Bloodmosher/Sysop-64/Boards/DE10-Nano/Top_Plates/Sysop-64_3_Button_Logo/V1.6/DE10-V1.6-HatC-BOM.txt

Comment	Designator	Footprint	JLCPCB Part #?optional?
RT0805BRB0710KL	"R1,R2"	R0805	C864029
CRGCQ0805J470R (480 Ohm)	"R3,R4"	R0805	C4236587
TSM-120-03-T-DV-A	J1	 2.54mm Spacing 20p Double row pin header	C21501942
TL1100DF160Q	"SW1,SW2,SW3"	"Plugin, 12x12mm"	C273460
150080BS75000 (Blue 470nm LED)	"D1,D2"	LED_0805	C9900019499
