Bloodmosher/Sysop-64/linux-code/libsysop64/include/sysop_defines.h

/*
 * Sysop-64
 * https://github.com/Bloodmosher/Sysop-64
 *
 * SPDX-License-Identifier: MIT
 * Copyright (c) 2026 Sysop-64 Project
 */

#ifndef SYSOP_DEFINES_H
#define SYSOP_DEFINES_H

#include <stdint.h>

#define SYSOP64_BRIDGE 0xC0000000
#define SYSOP64_BRIDGE_SPAN 0x40bff
#define SYSOP64_SAMPLER_BUFFER_ADDRESS 0x21000000
#define SYSOP64_SAMPLER_BUFFER_SIZE (12500000*8) // 12.5M samples, 8 bytes each
#define SYSOP64_SAMPLER_MAX_SAMPLES 12500000
#define SYSOP64_TICK_SAMPLER_BUFFER_ADDRESS 0x21000000
#define SYSOP64_TICK_SAMPLER_BUFFER_SIZE 0x06000000
#define SYSOP64_TICK_SAMPLER_WORD_BYTES 32
#define SYSOP64_HDMI_CMD_DATA 0x40810
#define SYSOP64_CMD3_PARAM    0x40800
#define SYSOP64_FPGA_STATUS   0x40808
#define SYSOP64_PHI2_COUNTER 0x40818
#define SYSOP64_C64_SIGNALS 0x40820
#define SYSOP64_MAP_DEBUG_DATA1 0x40828
#define SYSOP64_CMD3_RESULT 0x40830
#define SYSOP64_HDMI_INFO_RESULT 0x40838
#define SYSOP64_SID_VOICES_DATA 0x40840
#define SYSOP64_GPIO_DATA 0x40848
#define SYSOP64_DMA_READ_KEY_DATA 0x40850
#define SYSOP64_DMA_TAG_DATA 0x40858
#define SYSOP64_DMA_JOYSTICK_DATA 0x40860
#define SYSOP64_AUDIO_STATUS 0x40868
#define SYSOP64_AUDIO_COMMAND 0x40870

#define SYSOP64_DMA_WRITE_ADDRESS 0x40400
#define SYSOP64_DMA_WRITE_DATA 0x40000
#define SYSOP64_DMA_READ_ADDRESS 0x40402
#define SYSOP64_DMA_READ_DATA 0x40001
#define SYSOP64_CMD_ADDRESS 0x40404
#define SYSOP64_CMD2_ADDRESS 0x40C00
#define SYSOP64_SET_PALETTE_ADDRESS 0x40C04
#define SYSOP64_CMD3_ADDRESS 0x40C08

#define SYSOP64_CMD2_ID_READ 0
#define SYSOP64_CMD2_ID_WRITE 1
#define SYSOP64_CMD2_ID_WAIT_VIC 2

#define SYSOP64_INTERNAL_READ_ADDRESS 0x40406
#define SYSOP64_INTERNAL_READ_DATA 0x40002

#define SYSOP64_CMD_ID_RESET 0
#define SYSOP64_CMD_ID_DMA_FREEZE 1
#define SYSOP64_CMD_ID_DMA_UNFREEZE 2
#define SYSOP64_CMD_ID_ENABLE_CARTRIDGE_8K 3
#define SYSOP64_CMD_ID_DISABLE_CARTRIDGE 4
#define SYSOP64_CMD_ID_NMI_FREEZE 5
#define SYSOP64_CMD_ID_NMI_UNFREEZE 6
#define SYSOP64_CMD_ID_ENABLE_IO 7
#define SYSOP64_CMD_ID_DISABLE_IO 8
#define SYSOP64_CMD_ID_ENABLE_NMI_TRAP 9
#define SYSOP64_CMD_ID_DISABLE_NMI_TRAP 10
#define SYSOP64_CMD_TEST_SDRAM_READ 11

#define SYSOP64_CMD_ID_TRIGGER_SAMPLER 13
#define SYSOP64_CMD_ID_SHOW_FRAMEBUFFER 14
#define SYSOP64_CMD_ID_HIDE_FRAMEBUFFER 15
#define SYSOP64_CMD_ID_FLIP_FRAMEBUFFER 16
#define SYSOP64_CMD_ID_ENABLE_CARTRIDGE_16K 17

#define SYSOP64_CMD_ID_ENABLE_CARTRIDGE_ULTIMAX 25
#define SYSOP64_CMD_ID_ENABLE_EASYFLASH_DMA_TRIGGER 26
#define SYSOP64_CMD_ID_DISABLE_EASYFLASH_DMA_TRIGGER 27

#define SYSOP64_CMD_ID_ENABLE_REU_DMA_TRIGGER 34
#define SYSOP64_CMD_ID_DISABLE_REU_DMA_TRIGGER 35
#define SYSOP64_CMD_ID_TRIGGER_TICK_SAMPLER 41
#define SYSOP64_CMD_ID_STOP_TICK_SAMPLER 42
#define SYSOP64_CMD_ID_TRIGGER_BUSMON_DEBUG_SAMPLER 43
#define SYSOP64_CMD_ID_STOP_BUSMON_DEBUG_SAMPLER 44
#define SYSOP64_CMD_ID_ENABLE_BUSMON_CHL_ALERT 45
#define SYSOP64_CMD_ID_DISABLE_BUSMON_CHL_ALERT 46
#define SYSOP64_CMD_ID_ENABLE_BUSMON_CHL_OVERRIDE 47
#define SYSOP64_CMD_ID_DISABLE_BUSMON_CHL_OVERRIDE 48
#define SYSOP64_CMD_ID_TRIGGER_VIC_DEBUG_SAMPLER 49
#define SYSOP64_CMD_ID_STOP_VIC_DEBUG_SAMPLER 50
#define SYSOP64_CMD_ID_SELECT_SID2_6581 56
#define SYSOP64_CMD_ID_SELECT_SID2_8580 57
#define SYSOP64_CMD_ID_ENABLE_SID2 58
#define SYSOP64_CMD_ID_DISABLE_SID2 59
// archived isevic_debugger: #define SYSOP64_CMD_ID_TRIGGER_ISEVIC_DEBUG_SAMPLER 51
// archived isevic_debugger: #define SYSOP64_CMD_ID_STOP_ISEVIC_DEBUG_SAMPLER 52
// archived isevic_debugger: #define SYSOP64_CMD_ID_ENABLE_ISEVIC_REPLAY 53
// archived isevic_debugger: #define SYSOP64_CMD_ID_DISABLE_ISEVIC_REPLAY 54

#define SYSOP64_CMD3_ID_GET_COLOR 1
#define SYSOP64_CMD3_ID_IO_POKE 2
#define SYSOP64_CMD3_IRQ_SET 3
#define SYSOP64_CMD3_IRQ_CLEAR 4
#define SYSOP64_CMD3_SETUP_WRITE_IO_STROBE 5
#define SYSOP64_CMD3_RESET_STROBE 6
#define SYSOP64_CMD3_SETUP_READ_STROBE 7
#define SYSOP64_CMD3_READ_CPU_FREQ 8
#define SYSOP64_CMD3_READ_LINE_TIMING 9
#define SYSOP64_CMD3_SET_PLL_DATA 10
#define SYSOP64_CMD3_PLL_RECONFIG 11
#define SYSOP64_CMD3_READ_VIC_INFO 12
#define SYSOP64_CMD3_GET_DMA_INFO 13
#define SYSOP64_CMD3_GET_VERSION_INFO 14
#define SYSOP64_CMD3_READ_STATUS_1 15
#define SYSOP64_CMD3_VIDEO_RESET 16
#define SYSOP64_CMD3_SCREENSHOT_REQUEST 17
#define SYSOP64_CMD3_SCREENSHOT_STATUS 18
#define SYSOP64_CMD3_SCREENSHOT_READ 19
#define SYSOP64_CMD3_SET_DMA_TIMING_NTSC 20
#define SYSOP64_CMD3_SET_DMA_TIMING_PAL 21
//#define SYSOP64_CMD3_SET_LINE_NUMBER 22
#define SYSOP64_CMD3_SETUP_RASTER_STROBE 23
#define SYSOP64_CMD3_SETUP_WRITE_STROBE 24
#define SYSOP64_CMD3_NAMESOFT_MIDI_READ_READY 25
#define SYSOP64_CMD3_NAMESOFT_MIDI_WRITE_DATA 26
#define SYSOP64_CMD3_SET_NMI_VECTOR 27
#define SYSOP64_CMD3_SET_TICK_SAMPLER_CONFIG 28
#define SYSOP64_CMD3_READ_TICK_SAMPLER_STATUS 29
#define SYSOP64_CMD3_READ_INFERRED_PORT_01 30
#define SYSOP64_CMD3_RESET_C64_BUS_MONITOR 31
#define SYSOP64_CMD3_READ_PORT01_DEBUG0 32
#define SYSOP64_CMD3_READ_PORT01_DEBUG1 33
#define SYSOP64_CMD3_READ_PORT01_DEBUG2 34
#define SYSOP64_CMD3_READ_PORT01_DEBUG3 35
#define SYSOP64_CMD3_READ_PORT01_DEBUG4 36
#define SYSOP64_CMD3_READ_PORT01_DEBUG5 37
#define SYSOP64_CMD3_READ_PORT01_DEBUG6 38
#define SYSOP64_CMD3_READ_PORT01_DEBUG7 39
#define SYSOP64_CMD3_READ_PORT01_DEBUG8 40
#define SYSOP64_CMD3_READ_PORT01_DEBUG9 41
#define SYSOP64_CMD3_READ_PORT01_DEBUG10 42
#define SYSOP64_CMD3_READ_PORT01_DEBUG11 43
#define SYSOP64_CMD3_READ_PORT01_DEBUG12 44
#define SYSOP64_CMD3_READ_PORT01_DEBUG13 45
#define SYSOP64_CMD3_READ_PORT01_DEBUG14 46
#define SYSOP64_CMD3_READ_PORT01_DEBUG15 47
#define SYSOP64_CMD3_READ_PORT01_DEBUG16 48
#define SYSOP64_CMD3_READ_PORT01_DEBUG17 49
#define SYSOP64_CMD3_WRITE_SID_FILTER_TABLE 50
#define SYSOP64_CMD3_SET_SID_FILTER_CONTROL 51
#define SYSOP64_CMD3_SET_SID_FILTER_SCALE 52
#define SYSOP64_CMD3_WRITE_SID_FILTER_TABLE_SID2 53
#define SYSOP64_CMD3_SET_SID_FILTER_CONTROL_SID2 54
#define SYSOP64_CMD3_SET_SID_FILTER_SCALE_SID2 55
#define SYSOP64_CMD3_SET_SID2_BASE 56

#define VIC_CHIP_6567R56A 0
#define VIC_CHIP_6567R8 1
#define VIC_CHIP_6569 2
#define VIC_CHIP_6572RO_DREAN 3

typedef uint8_t BOOL;
#ifndef TRUE
#define TRUE 1
#endif

#endif /* SYSOP_DEFINES_H */
