Bloodmosher/Sysop-64/linux-code/libsysop64/include/c64keys.h

/*
 * Sysop-64
 * https://github.com/Bloodmosher/Sysop-64
 *
 * SPDX-License-Identifier: MIT
 * Copyright (c) 2026 Sysop-64 Project
 */

#ifndef C64_KEYS_H
#define C64_KEYS_H


#define C64_KEY_STOP 0
#define C64_KEY_RUN 0
#define C64_KEY_Q 1
#define C64_KEY_CMD 2
#define C64_KEY_SPACE 3
#define C64_KEY_2 4
#define C64_KEY_CTRL 5
#define C64_KEY_ESC 6
#define C64_KEY_1 7

#define C64_KEY_SLASH 8
#define C64_KEY_ARROW_UP 9
#define C64_KEY_PI 9
#define C64_KEY_EQUAL 10
#define C64_KEY_RIGHT_SHIFT 11
#define C64_KEY_HOME 12
#define C64_KEY_CLR 12
#define C64_KEY_SEMICOLON 13
#define C64_KEY_STAR 14
#define C64_KEY_LBS 15

#define C64_KEY_COMMA 16
#define C64_KEY_AT 17
#define C64_KEY_COLON 18
#define C64_KEY_PERIOD 19
#define C64_KEY_MINUS 20
#define C64_KEY_L 21
#define C64_KEY_P 22
#define C64_KEY_PLUS 23

#define C64_KEY_N 24
#define C64_KEY_O 25
#define C64_KEY_K 26
#define C64_KEY_M 27
#define C64_KEY_ZERO 28
#define C64_KEY_J 29
#define C64_KEY_I 30
#define C64_KEY_9 31

#define C64_KEY_V 32
#define C64_KEY_U 33
#define C64_KEY_H 34
#define C64_KEY_B 35
#define C64_KEY_8 36
#define C64_KEY_G 37
#define C64_KEY_Y 38
#define C64_KEY_7 39

#define C64_KEY_X 40
#define C64_KEY_T 41
#define C64_KEY_F 42
#define C64_KEY_C 43
#define C64_KEY_6 44
#define C64_KEY_D 45
#define C64_KEY_R 46
#define C64_KEY_5 47

#define C64_KEY_LEFT_SHIFT 48
#define C64_KEY_E 49
#define C64_KEY_S 50
#define C64_KEY_Z 51
#define C64_KEY_4 52
#define C64_KEY_A 53
#define C64_KEY_W 54
#define C64_KEY_3 55

#define C64_KEY_CRSR_DOWN 56
#define C64_KEY_CRSR_UP 56
#define C64_KEY_F5 57
#define C64_KEY_F6 57
#define C64_KEY_F3 58
#define C64_KEY_F4 58
#define C64_KEY_F1 59
#define C64_KEY_F2 59
#define C64_KEY_F7 60
#define C64_KEY_F8 60
#define C64_KEY_CRSR_RIGHT 61
#define C64_KEY_CRSR_LEFT 61
#define C64_KEY_RETURN 62
#define C64_KEY_DELETE 63
#define C64_KEY_INSERT 63

#define C64_KEY_DOWN 1
#define C64_KEY_UP 0


#endif /* C64_KEYS_H */
