Bloodmosher/Sysop-64/linux-code/libsysop64/include/keyboard.h

/*
 * Sysop-64
 * https://github.com/Bloodmosher/Sysop-64
 *
 * SPDX-License-Identifier: MIT
 * Copyright (c) 2026 Sysop-64 Project
 */

#ifndef KEYBOARD_H
#define KEYBOARD_H


#define KEY_STOP 0
#define KEY_RUN 0
#define KEY_Q 1
#define KEY_CMD 2
#define KEY_SPACE 3
#define KEY_2 4
#define KEY_CTRL 5
#define KEY_ESC 6
#define KEY_1 7

#define KEY_SLASH 8
#define KEY_ARROW_UP 9
#define KEY_PI 9
#define KEY_EQUAL 10
#define KEY_RIGHT_SHIFT 11
#define KEY_HOME 12
#define KEY_CLR 12
#define KEY_SEMICOLON 13
#define KEY_STAR 14
#define KEY_LBS 15

#define KEY_COMMA 16
#define KEY_AT 17
#define KEY_COLON 18
#define KEY_PERIOD 19
#define KEY_MINUS 20
#define KEY_L 21
#define KEY_P 22
#define KEY_PLUS 23

#define KEY_N 24
#define KEY_O 25
#define KEY_K 26
#define KEY_M 27
#define KEY_ZERO 28
#define KEY_J 29
#define KEY_I 30
#define KEY_9 31

#define KEY_V 32
#define KEY_U 33
#define KEY_H 34
#define KEY_B 35
#define KEY_8 36
#define KEY_G 37
#define KEY_Y 38
#define KEY_7 39

#define KEY_X 40
#define KEY_T 41
#define KEY_F 42
#define KEY_C 43
#define KEY_6 44
#define KEY_D 45
#define KEY_R 46
#define KEY_5 47

#define KEY_LEFT_SHIFT 48
#define KEY_E 49
#define KEY_S 50
#define KEY_Z 51
#define KEY_4 52
#define KEY_A 53
#define KEY_W 54
#define KEY_3 55

#define KEY_CRSR_DOWN 56
#define KEY_CRSR_UP 56
#define KEY_F5 57
#define KEY_F6 57
#define KEY_F3 58
#define KEY_F4 58
#define KEY_F1 59
#define KEY_F2 59
#define KEY_F7 60
#define KEY_F8 60
#define KEY_CRSR_RIGHT 61
#define KEY_CRSR_LEFT 61
#define KEY_RETURN 62
#define KEY_DELETE 63
#define KEY_INSERT 63

int isShiftKeyDown();

#endif /* KEYBOARD_H */
