Bloodmosher/Sysop-64/linux-code/tools/sidcontrol.c

/*
 * SPDX-License-Identifier: MIT
 * Copyright (c) 2026 Sysop-64 Project
 */

/*
 * Sysop-64 SID filter table uploader.
 *
 * The FPGA custom table is initialized to the Galway curve.  This tool can
 * upload either built-in preset, upload an arbitrary 1024-entry hex/text file,
 * switch the SID filter between the built-in curve and the custom table,
 * and adjust the runtime cutoff scale for the 6581/8580 models.
 */

#include <ctype.h>
#include <errno.h>
#include <math.h>
#include <stdint.h>
#include <stdbool.h>
#include <stdio.h>
#include <stdlib.h>
#include <string.h>
#include <strings.h>
#include <unistd.h>
#include <arpa/inet.h>
#include <netinet/in.h>
#include <sys/socket.h>
#include <sys/types.h>

#include "sysop_library.h"

static const int16_t galway_6581_table[1024] = {
       261,    262,    262,    263,    263,    264,    264,    265,
       265,    266,    266,    267,    267,    267,    268,    269,
       268,    269,    269,    270,    271,    271,    272,    272,
       273,    273,    274,    275,    275,    276,    276,    277,
       276,    277,    278,    279,    279,    280,    281,    281,
       282,    283,    283,    284,    285,    286,    286,    287,
       287,    288,    289,    290,    290,    291,    292,    293,
       293,    294,    295,    296,    297,    298,    299,    300,
       297,    299,    299,    301,    301,    303,    303,    305,
       305,    306,    307,    309,    309,    310,    312,    313,
       313,    314,    315,    316,    317,    319,    320,    322,
       322,    324,    325,    326,    327,    329,    330,    332,
       330,    332,    333,    335,    336,    338,    339,    341,
       342,    343,    345,    347,    348,    350,    351,    353,
       353,    355,    357,    358,    360,    362,    364,    366,
       367,    369,    371,    373,    375,    377,    379,    381,
       369,    371,    373,    375,    376,    379,    381,    384,
       384,    387,    389,    391,    393,    396,    398,    400,
       400,    403,    405,    408,    410,    413,    415,    419,
       420,    423,    425,    428,    430,    433,    435,    439,
       436,    440,    442,    446,    448,    452,    455,    458,
       460,    464,    466,    470,    472,    476,    479,    483,
       483,    487,    490,    494,    497,    502,    505,    510,
       511,    516,    519,    524,    528,    531,    536,    541,
       529,    534,    538,    543,    545,    550,    556,    561,
       561,    567,    572,    576,    580,    586,    590,    596,
       596,    602,    607,    613,    617,    624,    628,    635,
       637,    644,    649,    656,    658,    666,    670,    678,
       673,    680,    685,    693,    698,    706,    711,    720,
       722,    731,    736,    745,    748,    756,    762,    771,
       771,    780,    786,    796,    802,    812,    818,    828,
       831,    841,    848,    858,    865,    872,    883,    894,
       786,    796,    802,    812,    818,    828,    835,    845,
       848,    858,    865,    876,    883,    894,    901,    913,
       909,    920,    932,    943,    947,    959,    967,    980,
       984,    996,   1005,   1018,   1026,   1039,   1048,   1062,
      1048,   1062,   1076,   1090,   1094,   1109,   1118,   1133,
      1138,   1153,   1163,   1178,   1189,   1204,   1215,   1231,
      1231,   1248,   1259,   1275,   1281,   1298,   1316,   1328,
      1333,   1351,   1364,   1382,   1395,   1413,   1426,   1446,
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
};

static const int16_t sysop64_6581_table[1024] = {
       466,    466,    466,    466,    468,    468,    471,    474,
       474,    472,    468,    463,    460,    459,    460,    462,
       465,    469,    472,    477,    480,    480,    477,    475,
       475,    474,    474,    474,    474,    472,    472,    472,
       474,    471,    471,    468,    468,    468,    469,    472,
       475,    475,    478,    480,    482,    485,    488,    490,
       491,    489,    488,    485,    482,    478,    474,    472,
       471,    471,    472,    475,    477,    477,    478,    480,
       480,    478,    477,    474,    474,    474,    477,    479,
       482,    485,    487,    489,    490,    489,    489,    487,
       486,    485,    485,    484,    484,    484,    484,    486,
       486,    485,    483,    482,    482,    481,    481,    483,
       485,    488,    493,    497,    500,    498,    496,    493,
       491,    491,    492,    494,    496,    496,    497,    499,
       499,    497,    494,    490,    491,    494,    501,    507,
       510,    509,    504,    500,    497,    498,    498,    502,
       504,    504,    503,    501,    502,    503,    506,    509,
       512,    512,    512,    512,    513,    513,    514,    516,
       517,    516,    514,    513,    513,    514,    517,    520,
       523,    524,    523,    524,    526,    529,    536,    541,
       543,    539,    531,    523,    520,    522,    528,    534,
       539,    541,    543,    543,    545,    545,    544,    543,
       545,    545,    549,    552,    552,    549,    546,    543,
       543,    548,    557,    566,    573,    575,    573,    570,
       570,    570,    572,    574,    577,    578,    581,    583,
       587,    590,    593,    597,    598,    596,    594,    591,
       591,    594,    598,    604,    608,    608,    606,    605,
       605,    605,    606,    608,    609,    610,    611,    612,
       615,    619,    623,    629,    635,    637,    640,    643,
       646,    648,    651,    653,    655,    654,    653,    653,
       655,    659,    665,    671,    677,    680,    682,    683,
       689,    696,    707,    717,    724,    724,    718,    713,
       713,    717,    725,    735,    742,    743,    743,    743,
       745,    749,    755,    760,    767,    772,    777,    782,
       788,    792,    799,    806,    811,    812,    815,    816,
       822,    827,    838,    848,    856,    861,    866,    869,
       875,    880,    888,    897,    903,    909,    911,    914,
       920,    928,    940,    952,    960,    965,    968,    972,
       978,    985,    996,   1006,   1017,   1026,   1034,   1043,
      1053,   1062,   1072,   1082,   1092,   1102,   1110,   1119,
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
};

static void usage(const char *argv0)
{
    fprintf(stderr,
        "Usage:\n"
        "  %s builtin\n"
        "  %s custom\n"
        "  %s sid-6581 | 6581\n"
        "  %s sid-8580 | 8580\n"
        "  %s sid-volume <0-255>\n"
        "  %s upload-galway [--activate]\n"
        "  %s upload-follin [--activate]\n"
        "  %s upload-average [--activate]\n"
        "  %s upload-strong [--activate]\n"
        "  %s upload-extreme [--activate]\n"
        "  %s upload-sysop64 [--activate]\n"
        "  %s upload <table.hex> [--activate]\n"
        "  %s scale-6581 <scale>\n"
        "  %s scale-8580 <scale>\n"
        "  %s sid2-enable\n"
        "  %s sid2-disable\n"
        "  %s sid2-base DE00|DE20|...|DFE0\n"
        "  %s server [port] [html-path]\n"
        "\n"
        "Tables are 1024 signed 16-bit entries. File input accepts hex values,\n"
        "one or more per line; // comments are ignored.\n",
        argv0, argv0, argv0, argv0, argv0, argv0, argv0, argv0, argv0, argv0,
        argv0, argv0, argv0, argv0, argv0, argv0, argv0, argv0);
}


static int parse_scale_q8_8(const char *text, uint16_t *out)
{
    char *end = NULL;
    errno = 0;
    double value = strtod(text, &end);
    if (end == text || *end != '\0' || errno != 0 || value < 0.0) {
        return -1;
    }

    double scaled = value * 256.0;
    if (scaled > 65535.0) {
        return -1;
    }

    *out = (uint16_t)(scaled + 0.5);
    return 0;
}

static int parse_u8(const char *text, uint8_t *out)
{
    char *end = NULL;
    errno = 0;
    unsigned long value = strtoul(text, &end, 0);
    if (end == text || *end != '\0' || errno != 0 || value > 255) {
        return -1;
    }
    *out = (uint8_t)value;
    return 0;
}

static uint8_t selected_sid = 1;

static int parse_sid_number(const char *text, uint8_t *sid)
{
    if (strcmp(text, "1") == 0 || strcmp(text, "sid1") == 0 || strcmp(text, "SID1") == 0) {
        *sid = 1;
        return 0;
    }
    if (strcmp(text, "2") == 0 || strcmp(text, "sid2") == 0 || strcmp(text, "SID2") == 0) {
        *sid = 2;
        return 0;
    }
    return -1;
}

static int set_sid_model_for(uint8_t sid, const char *model)
{
    if (strcmp(model, "6581") == 0 || strcmp(model, "sid-6581") == 0 || strcmp(model, "--sid-6581") == 0) {
        sysop_sid_set_model(sid, false);
        return 0;
    }
    if (strcmp(model, "8580") == 0 || strcmp(model, "sid-8580") == 0 || strcmp(model, "--sid-8580") == 0) {
        sysop_sid_set_model(sid, true);
        return 0;
    }
    return -1;
}

static int set_sid_model(const char *model)
{
    return set_sid_model_for(selected_sid, model);
}

static int parse_sid_base(const char *text, uint16_t *base)
{
    char *end = NULL;
    int radix = 16;
    errno = 0;
    if (text[0] == '0' && (text[1] == 'x' || text[1] == 'X')) {
        radix = 0;
    }
    unsigned long value = strtoul(text, &end, radix);
    if (end == text || *end != '\0' || errno != 0 || value < 0xde00 || value > 0xdfff || (value & 0x1f) != 0) {
        return -1;
    }
    *base = (uint16_t)value;
    return 0;
}
static int parse_value(const char *token, int16_t *out)
{
    char *end = NULL;
    int base = 16;

    if (token[0] == '-' || token[0] == '+') {
        base = 0;
    } else if (token[0] == '0' && (token[1] == 'x' || token[1] == 'X')) {
        base = 0;
    }

    errno = 0;
    long value = strtol(token, &end, base);
    if (end == token || *end != '\0' || errno != 0) {
        return -1;
    }

    if (value < -32768 || value > 0xffff) {
        return -1;
    }

    *out = (int16_t)(uint16_t)value;
    return 0;
}

static int load_table_file(const char *path, int16_t *table, size_t count)
{
    FILE *fp = fopen(path, "r");
    if (!fp) {
        perror(path);
        return -1;
    }

    char line[512];
    size_t index = 0;
    while (fgets(line, sizeof(line), fp)) {
        char *comment = strstr(line, "//");
        if (comment) {
            *comment = '\0';
        }

        char *token = strtok(line, " \t\r\n,");
        while (token) {
            if (index >= count) {
                fprintf(stderr, "%s: too many entries\n", path);
                fclose(fp);
                return -1;
            }
            if (parse_value(token, &table[index]) != 0) {
                fprintf(stderr, "%s: invalid value '%s'\n", path, token);
                fclose(fp);
                return -1;
            }
            index++;
            token = strtok(NULL, " \t\r\n,");
        }
    }

    fclose(fp);

    if (index != count) {
        fprintf(stderr, "%s: expected %zu entries, got %zu\n", path, count, index);
        return -1;
    }

    return 0;
}


static uint16_t sid_default_fc_dac(uint16_t fc)
{
    static const uint16_t dac_6581_cutoff_bits[11] = {
        0x0020, 0x002f, 0x0052, 0x009c, 0x012b, 0x0243,
        0x0463, 0x0880, 0x107b, 0x1ff4, 0x3df3
    };
    uint32_t sum = 1u << 3;

    for (unsigned bit = 0; bit < 11; bit++) {
        if (fc & (1u << bit)) {
            sum += dac_6581_cutoff_bits[bit];
        }
    }

    return (uint16_t)(sum >> 4);
}

static int16_t clamp_s16_long(long value)
{
    if (value < -32768) {
        return -32768;
    }
    if (value > 32767) {
        return 32767;
    }
    return (int16_t)value;
}

static void fill_6581_curve_table(int16_t *table, double fc_base, double curve_shift)
{
    const double fc_offset = 1024.0 + 512.0 + curve_shift;

    for (uint16_t i = 0; i < 1024; i++) {
        uint16_t fc = (uint16_t)(i << 1);
        double hz = fc_base + 12000.0 * (1.0 + tanh(((double)sid_default_fc_dac(fc) - fc_offset) / 350.0));
        long value = lround(hz * 0.8235496645826426);
        table[i] = clamp_s16_long(value);
    }
}

static void fill_sid_default_table(int16_t *table)
{
    const double y0 = 9883.0;
    const double fc_offset = 0x480;
    const double fc_base = 250.0;

    for (uint16_t i = 0; i < 1024; i++) {
        uint16_t fc = (uint16_t)(i << 1);
        double x = ((double)sid_default_fc_dac(fc) - fc_offset) / 350.0;
        long value = lround(fc_base + y0 + (y0 * tanh(x)));
        table[i] = clamp_s16_long(value);
    }
}

static int fill_named_preset_table(const char *name, int16_t *table)
{
    if (strcmp(name, "follin") == 0 || strcmp(name, "follin-style") == 0) {
        fill_6581_curve_table(table, 240.0, -785.0);
        return 0;
    }
    if (strcmp(name, "galway") == 0 || strcmp(name, "galway-style") == 0) {
        memcpy(table, galway_6581_table, sizeof(galway_6581_table));
        return 0;
    }
    if (strcmp(name, "average") == 0) {
        fill_6581_curve_table(table, 250.0, 0.0);
        return 0;
    }
    if (strcmp(name, "strong") == 0 || strcmp(name, "strong-filter") == 0) {
        fill_6581_curve_table(table, 260.0, 400.0);
        return 0;
    }
    if (strcmp(name, "extreme") == 0 || strcmp(name, "extreme-filter") == 0) {
        fill_6581_curve_table(table, 200.0, 760.0);
        return 0;
    }
    if (strcmp(name, "default") == 0) {
        fill_sid_default_table(table);
        return 0;
    }
    if (strcmp(name, "sysop64") == 0) {
        memcpy(table, sysop64_6581_table, sizeof(sysop64_6581_table));
        return 0;
    }
    return -1;
}
static void upload_table_to_sid(uint8_t sid, const int16_t *table)
{
    for (uint16_t i = 0; i < 1024; i++) {
        sysop_sid_filter_table_write_sid(sid, i, table[i]);
        if ((i & 0x7f) == 0x7f) {
            printf("uploaded %u/1024\n", (unsigned)i + 1);
        }
    }
}

static void upload_table(const int16_t *table)
{
    upload_table_to_sid(selected_sid, table);
}



static char *sidcontrol_html = NULL;
static char sidcontrol_html_path[512];

static char *read_text_file(const char *path, size_t *out_len)
{
    FILE *fp = fopen(path, "rb");
    char *data = NULL;
    long len;

    if (!fp) {
        return NULL;
    }

    if (fseek(fp, 0, SEEK_END) != 0) {
        fclose(fp);
        return NULL;
    }

    len = ftell(fp);
    if (len < 0) {
        fclose(fp);
        return NULL;
    }

    rewind(fp);
    data = malloc((size_t)len + 1);
    if (!data) {
        fclose(fp);
        return NULL;
    }

    if (fread(data, 1, (size_t)len, fp) != (size_t)len) {
        free(data);
        fclose(fp);
        return NULL;
    }

    fclose(fp);
    data[len] = '\0';
    if (out_len) {
        *out_len = (size_t)len;
    }
    return data;
}

static int try_load_html(const char *path)
{
    size_t len = 0;
    char *loaded = read_text_file(path, &len);
    if (!loaded) {
        return -1;
    }

    free(sidcontrol_html);
    sidcontrol_html = loaded;
    snprintf(sidcontrol_html_path, sizeof(sidcontrol_html_path), "%s", path);
    printf("sidcontrol: loaded web app %s (%zu bytes)\n", sidcontrol_html_path, len);
    return 0;
}

static int load_sidcontrol_html(const char *argv0, const char *requested_path)
{
    const char *fallbacks[] = {
        "sidcontrol.html",
        "../tools/sidcontrol.html",
        "../../tools/sidcontrol.html",
        "/usr/local/bin/sidcontrol.html",
        "/usr/local/share/sysop64/sidcontrol.html",
        "sidfilter.html",
        "../tools/sidfilter.html",
        "../../tools/sidfilter.html"
    };
    char beside_exe[512];
    const char *slash;

    if (requested_path) {
        if (try_load_html(requested_path) == 0) {
            return 0;
        }
        fprintf(stderr, "sidcontrol: could not load %s\n", requested_path);
        return -1;
    }

    slash = strrchr(argv0, '/');
    if (slash) {
        size_t dir_len = (size_t)(slash - argv0);
        if (dir_len + sizeof("/sidcontrol.html") < sizeof(beside_exe)) {
            memcpy(beside_exe, argv0, dir_len);
            strcpy(beside_exe + dir_len, "/sidcontrol.html");
            if (try_load_html(beside_exe) == 0) {
                return 0;
            }
        }
    }

    for (size_t i = 0; i < sizeof(fallbacks) / sizeof(fallbacks[0]); i++) {
        if (try_load_html(fallbacks[i]) == 0) {
            return 0;
        }
    }

    fprintf(stderr, "sidcontrol: could not find sidcontrol.html; pass an explicit path\n");
    return -1;
}

static int send_all(int fd, const char *data, size_t len)
{
    while (len > 0) {
        ssize_t sent = send(fd, data, len, 0);
        if (sent <= 0) {
            return -1;
        }
        data += sent;
        len -= (size_t)sent;
    }
    return 0;
}

static void http_send(int fd, const char *status, const char *type, const char *body)
{
    char header[256];
    size_t body_len = strlen(body);
    int header_len = snprintf(header, sizeof(header),
        "HTTP/1.1 %s\r\nContent-Type: %s\r\nContent-Length: %zu\r\nConnection: close\r\nAccess-Control-Allow-Origin: *\r\n\r\n",
        status, type, body_len);
    if (header_len > 0) {
        send_all(fd, header, (size_t)header_len);
        send_all(fd, body, body_len);
    }
}

static void http_send_table(int fd, const int16_t *table)
{
    char header[256];
    int header_len = snprintf(header, sizeof(header),
        "HTTP/1.1 200 OK\r\nContent-Type: text/plain\r\nConnection: close\r\nAccess-Control-Allow-Origin: *\r\n\r\n");
    send_all(fd, header, (size_t)header_len);

    char line[32];
    for (int i = 0; i < 1024; i++) {
        int line_len = snprintf(line, sizeof(line), "%d\n", table[i]);
        send_all(fd, line, (size_t)line_len);
    }
}

static const char *query_value(const char *path, const char *key, char *out, size_t out_len)
{
    const char *q = strchr(path, '?');
    size_t key_len = strlen(key);
    if (!q) {
        return NULL;
    }
    q++;
    while (*q) {
        const char *next = strchr(q, '&');
        size_t part_len = next ? (size_t)(next - q) : strlen(q);
        if (part_len > key_len + 1 && strncmp(q, key, key_len) == 0 && q[key_len] == '=') {
            size_t value_len = part_len - key_len - 1;
            if (value_len >= out_len) {
                value_len = out_len - 1;
            }
            memcpy(out, q + key_len + 1, value_len);
            out[value_len] = '\0';
            return out;
        }
        if (!next) {
            break;
        }
        q = next + 1;
    }
    return NULL;
}


static uint8_t get_query_sid(const char *path)
{
    char sid_text[16];
    if (query_value(path, "sid", sid_text, sizeof(sid_text)) && strcmp(sid_text, "2") == 0) {
        return 2;
    }
    return 1;
}

static size_t http_content_length(const char *req, const char *headers_end)
{
    const char *line = req;
    while (line && line < headers_end) {
        const char *line_end = strstr(line, "\r\n");
        if (!line_end || line_end > headers_end) {
            line_end = headers_end;
        }
        if ((size_t)(line_end - line) >= 15 && strncasecmp(line, "Content-Length:", 15) == 0) {
            return (size_t)strtoul(line + 15, NULL, 10);
        }
        if (line_end == headers_end) {
            break;
        }
        line = line_end + 2;
    }
    return 0;
}

static int parse_http_value(const char *text, int16_t *out)
{
    char *end = NULL;
    errno = 0;
    long value = strtol(text, &end, 0);
    if (end == text || *end != '\0' || errno != 0 || value < -32768 || value > 32767) {
        return -1;
    }
    *out = (int16_t)value;
    return 0;
}

static int parse_body_table(char *body, int16_t *table)
{
    size_t index = 0;
    char *token = strtok(body, " \t\r\n,");
    while (token) {
        if (index >= 1024 || parse_http_value(token, &table[index]) != 0) {
            return -1;
        }
        index++;
        token = strtok(NULL, " \t\r\n,");
    }
    return index == 1024 ? 0 : -1;
}

static int apply_entry_pairs(uint8_t sid, char *body)
{
    char *token = strtok(body, " \t\r\n,");
    while (token) {
        char *index_text = token;
        char *value_text = strtok(NULL, " \t\r\n,");
        int16_t value;
        unsigned long index;
        if (!value_text) {
            return -1;
        }
        index = strtoul(index_text, NULL, 0);
        if (index >= 1024 || parse_http_value(value_text, &value) != 0) {
            return -1;
        }
        sysop_sid_filter_table_write_sid(sid, (uint16_t)index, value);
        token = strtok(NULL, " \t\r\n,");
    }
    return 0;
}

static void handle_http_client(int fd)
{
    enum { REQ_MAX = 131072 };
    char req[REQ_MAX + 1];
    size_t used = 0;
    ssize_t got;
    char method[8] = {0};
    char path[512] = {0};

    while (used < REQ_MAX) {
        got = recv(fd, req + used, REQ_MAX - used, 0);
        if (got <= 0) {
            return;
        }
        used += (size_t)got;
        req[used] = '\0';
        char *headers_end = strstr(req, "\r\n\r\n");
        if (headers_end) {
            size_t header_bytes = (size_t)(headers_end + 4 - req);
            size_t content_length = http_content_length(req, headers_end);
            if (used >= header_bytes + content_length) {
                break;
            }
        }
    }

    if (sscanf(req, "%7s %511s", method, path) != 2) {
        http_send(fd, "400 Bad Request", "text/plain", "bad request\n");
        return;
    }

    char *headers_end = strstr(req, "\r\n\r\n");
    char *body = headers_end ? headers_end + 4 : req + used;

    if (strcmp(method, "GET") == 0 && (strcmp(path, "/") == 0 || strcmp(path, "/index.html") == 0)) {
        http_send(fd, "200 OK", "text/html", sidcontrol_html);    } else if (strcmp(method, "GET") == 0 && strncmp(path, "/preset?", 8) == 0) {
        char name[32];
        int16_t preset_table[1024];
        if (!query_value(path, "name", name, sizeof(name))) {
            strcpy(name, "galway");
        }
        if (fill_named_preset_table(name, preset_table) != 0) {
            http_send(fd, "404 Not Found", "text/plain", "unknown preset\n");
        } else {
            http_send_table(fd, preset_table);
        }
    } else if (strcmp(method, "POST") == 0 && strncmp(path, "/entries", 8) == 0) {
        if (apply_entry_pairs(get_query_sid(path), body) != 0) {
            http_send(fd, "400 Bad Request", "text/plain", "bad entries\n");
            return;
        }
        http_send(fd, "200 OK", "text/plain", "ok\n");
    } else if (strcmp(method, "POST") == 0 && strncmp(path, "/entry?", 7) == 0) {
        char index_text[32], value_text[32];
        int16_t value;
        unsigned long index;
        if (!query_value(path, "index", index_text, sizeof(index_text)) ||
            !query_value(path, "value", value_text, sizeof(value_text)) ||
            parse_http_value(value_text, &value) != 0) {
            http_send(fd, "400 Bad Request", "text/plain", "bad entry\n");
            return;
        }
        index = strtoul(index_text, NULL, 0);
        if (index >= 1024) {
            http_send(fd, "400 Bad Request", "text/plain", "bad index\n");
            return;
        }
        sysop_sid_filter_table_write_sid(get_query_sid(path), (uint16_t)index, value);
        http_send(fd, "200 OK", "text/plain", "ok\n");
    } else if (strcmp(method, "POST") == 0 && strncmp(path, "/apply", 6) == 0) {
        int16_t table[1024];
        if (parse_body_table(body, table) != 0) {
            http_send(fd, "400 Bad Request", "text/plain", "expected 1024 values\n");
            return;
        }
        for (uint16_t i = 0; i < 1024; i++) {
            sysop_sid_filter_table_write_sid(get_query_sid(path), i, table[i]);
        }
        http_send(fd, "200 OK", "text/plain", "ok\n");
    } else if (strcmp(method, "POST") == 0 && strncmp(path, "/activate?", 10) == 0) {
        char enable_text[16];
        int enable = query_value(path, "enable", enable_text, sizeof(enable_text)) ? atoi(enable_text) : 1;
        sysop_sid_filter_use_custom_sid(get_query_sid(path), enable != 0);
        http_send(fd, "200 OK", "text/plain", "ok\n");
    } else if (strcmp(method, "POST") == 0 && strncmp(path, "/sid-model?", 11) == 0) {
        char model[16];
        if (!query_value(path, "model", model, sizeof(model)) ||
            set_sid_model_for(get_query_sid(path), model) != 0) {
            http_send(fd, "400 Bad Request", "text/plain", "bad SID model\n");
            return;
        }
        http_send(fd, "200 OK", "text/plain", "ok\n");
    } else if (strcmp(method, "POST") == 0 && strncmp(path, "/sid-volume?", 12) == 0) {
        char value_text[32];
        uint8_t volume;
        if (!query_value(path, "value", value_text, sizeof(value_text)) ||
            parse_u8(value_text, &volume) != 0) {
            http_send(fd, "400 Bad Request", "text/plain", "bad SID volume\n");
            return;
        }
        sysop_audio_set_sid_volume(volume, volume);
        http_send(fd, "200 OK", "text/plain", "ok\n");
    } else if (strcmp(method, "POST") == 0 && strncmp(path, "/sid2-enable?", 13) == 0) {
        char enable_text[16];
        int enable;
        if (!query_value(path, "enable", enable_text, sizeof(enable_text))) {
            http_send(fd, "400 Bad Request", "text/plain", "missing enable\n");
            return;
        }
        enable = atoi(enable_text);
        sysop_sid2_enable(enable != 0);
        http_send(fd, "200 OK", "text/plain", enable ? "sid2 enabled\n" : "sid2 disabled\n");
    } else if (strcmp(method, "POST") == 0 && strncmp(path, "/sid2-base?", 11) == 0) {
        char base_text[32];
        uint16_t base;
        if (!query_value(path, "base", base_text, sizeof(base_text)) || parse_sid_base(base_text, &base) != 0) {
            http_send(fd, "400 Bad Request", "text/plain", "bad base\n");
            return;
        }
        sysop_sid2_set_base(base);
        http_send(fd, "200 OK", "text/plain", "sid2 base updated\n");
    } else if (strcmp(method, "POST") == 0 && strncmp(path, "/scale?", 7) == 0) {
        char model[16], value_text[32];
        uint16_t scale_q8_8;
        if (!query_value(path, "model", model, sizeof(model)) ||
            !query_value(path, "value", value_text, sizeof(value_text)) ||
            parse_scale_q8_8(value_text, &scale_q8_8) != 0) {
            http_send(fd, "400 Bad Request", "text/plain", "bad scale\n");
            return;
        }
        if (strcmp(model, "8580") == 0) {
            sysop_sid_filter_set_scale_8580_sid(get_query_sid(path), scale_q8_8);
        } else {
            sysop_sid_filter_set_scale_6581_sid(get_query_sid(path), scale_q8_8);
        }
        http_send(fd, "200 OK", "text/plain", "ok\n");
    } else {
        http_send(fd, "404 Not Found", "text/plain", "not found\n");
    }
}

static int run_http_server(uint16_t port)
{
    int server_fd = socket(AF_INET, SOCK_STREAM, 0);
    if (server_fd < 0) {
        perror("socket");
        return -1;
    }

    int one = 1;
    setsockopt(server_fd, SOL_SOCKET, SO_REUSEADDR, &one, sizeof(one));

    struct sockaddr_in addr;
    memset(&addr, 0, sizeof(addr));
    addr.sin_family = AF_INET;
    addr.sin_addr.s_addr = htonl(INADDR_ANY);
    addr.sin_port = htons(port);

    if (bind(server_fd, (struct sockaddr *)&addr, sizeof(addr)) < 0) {
        perror("bind");
        close(server_fd);
        return -1;
    }

    if (listen(server_fd, 8) < 0) {
        perror("listen");
        close(server_fd);
        return -1;
    }

    printf("sidcontrol: listening on http://0.0.0.0:%u/\n", (unsigned)port);
    fflush(stdout);

    for (;;) {
        int client_fd = accept(server_fd, NULL, NULL);
        if (client_fd < 0) {
            if (errno == EINTR) {
                continue;
            }
            perror("accept");
            close(server_fd);
            return -1;
        }
        handle_http_client(client_fd);
        close(client_fd);
    }
}

static int has_activate(int argc, char **argv, int start)
{
    for (int i = start; i < argc; i++) {
        if (strcmp(argv[i], "--activate") == 0) {
            return 1;
        }
        fprintf(stderr, "unknown option: %s\n", argv[i]);
        return -1;
    }
    return 0;
}

int main(int argc, char **argv)
{
    int rc = 1;
    const int16_t *table = NULL;
    int16_t file_table[1024];
    int activate_arg = 2;
    int activate = 0;
    uint16_t scale_q8_8 = 0;

    if (argc < 2) {
        usage(argv[0]);
        return 1;
    }

    if (argc >= 3 && strcmp(argv[1], "--sid") == 0) {
        if (parse_sid_number(argv[2], &selected_sid) != 0) {
            fprintf(stderr, "invalid SID number: %s\n", argv[2]);
            return 1;
        }
        argv += 2;
        argc -= 2;
    }

    if (sysop_init() < 0) {
        return 1;
    }

    if (strcmp(argv[1], "server") == 0) {
        uint16_t port = 8080;
        const char *html_path = NULL;
        if (argc > 4) {
            usage(argv[0]);
            goto out;
        }
        if (argc >= 3) {
            char *end = NULL;
            unsigned long parsed_port = strtoul(argv[2], &end, 0);
            if (end != argv[2] && *end == '\0') {
                if (parsed_port == 0 || parsed_port > 65535) {
                    fprintf(stderr, "invalid port '%s'\n", argv[2]);
                    goto out;
                }
                port = (uint16_t)parsed_port;
                if (argc == 4) {
                    html_path = argv[3];
                }
            } else {
                if (argc == 4) {
                    usage(argv[0]);
                    goto out;
                }
                html_path = argv[2];
            }
        }
        if (load_sidcontrol_html(argv[0], html_path) != 0) {
            goto out;
        }
        rc = run_http_server(port) == 0 ? 0 : 1;
        goto out;
    }

    if (strcmp(argv[1], "sid2-enable") == 0) {
        sysop_sid2_enable(true);
        printf("sid2 enabled\n");
        rc = 0;
        goto out;
    }

    if (strcmp(argv[1], "sid2-disable") == 0) {
        sysop_sid2_enable(false);
        printf("sid2 disabled\n");
        rc = 0;
        goto out;
    }

    if (strcmp(argv[1], "sid2-base") == 0) {
        uint16_t base;
        if (argc != 3 || parse_sid_base(argv[2], &base) != 0) {
            fprintf(stderr, "usage: %s sid2-base DE00|DE20|...|DFE0\n", argv[0]);
            goto out;
        }
        sysop_sid2_set_base(base);
        printf("sid2 base set to $%04X\n", base);
        rc = 0;
        goto out;
    }

    if (strcmp(argv[1], "builtin") == 0) {
        sysop_sid_filter_use_custom(false);
        printf("SID filter: built-in table selected\n");
        rc = 0;
        goto out;
    }

    if (strcmp(argv[1], "custom") == 0) {
        sysop_sid_filter_use_custom(true);
        printf("SID filter: custom table selected\n");
        rc = 0;
        goto out;
    }

    if (strcmp(argv[1], "sid-6581") == 0 || strcmp(argv[1], "--sid-6581") == 0 || strcmp(argv[1], "6581") == 0 ||
        strcmp(argv[1], "sid-8580") == 0 || strcmp(argv[1], "--sid-8580") == 0 || strcmp(argv[1], "8580") == 0) {
        if (argc != 2) {
            usage(argv[0]);
            goto out;
        }
        if (set_sid_model(argv[1]) != 0) {
            usage(argv[0]);
            goto out;
        }
        printf("SID model: %s\n", strstr(argv[1], "8580") ? "8580" : "6581");
        rc = 0;
        goto out;
    }

    if (strcmp(argv[1], "sid-volume") == 0 || strcmp(argv[1], "volume") == 0 || strcmp(argv[1], "--set-sid-volume") == 0) {
        uint8_t volume;
        if (argc != 3 || parse_u8(argv[2], &volume) != 0) {
            usage(argv[0]);
            goto out;
        }
        sysop_audio_set_sid_volume(volume, volume);
        printf("SID volume: %u\n", (unsigned)volume);
        rc = 0;
        goto out;
    }

    if (strcmp(argv[1], "scale-6581") == 0 || strcmp(argv[1], "scale-8580") == 0) {
        if (argc != 3) {
            usage(argv[0]);
            goto out;
        }
        if (parse_scale_q8_8(argv[2], &scale_q8_8) != 0) {
            fprintf(stderr, "invalid scale '%s' (use a non-negative value up to 255.996)\n", argv[2]);
            goto out;
        }

        if (strcmp(argv[1], "scale-6581") == 0) {
            sysop_sid_filter_set_scale_6581_sid(selected_sid, scale_q8_8);
            printf("SID 6581 cutoff scale: %s (q8.8=%u)\n", argv[2], scale_q8_8);
        } else {
            sysop_sid_filter_set_scale_8580_sid(selected_sid, scale_q8_8);
            printf("SID 8580 cutoff scale: %s (q8.8=%u)\n", argv[2], scale_q8_8);
        }
        rc = 0;
        goto out;
    }    if (strcmp(argv[1], "upload-galway") == 0 ||
        strcmp(argv[1], "upload-follin") == 0 ||
        strcmp(argv[1], "upload-average") == 0 ||
        strcmp(argv[1], "upload-strong") == 0 ||
        strcmp(argv[1], "upload-extreme") == 0 ||
        strcmp(argv[1], "upload-sysop64") == 0) {
        const char *name = argv[1] + strlen("upload-");
        if (fill_named_preset_table(name, file_table) != 0) {
            fprintf(stderr, "unknown preset '%s'\n", name);
            goto out;
        }
        table = file_table;
    } else if (strcmp(argv[1], "upload") == 0) {
        if (argc < 3) {
            usage(argv[0]);
            goto out;
        }
        if (load_table_file(argv[2], file_table, 1024) != 0) {
            goto out;
        }
        table = file_table;
        activate_arg = 3;
    } else {
        usage(argv[0]);
        goto out;
    }

    activate = has_activate(argc, argv, activate_arg);
    if (activate < 0) {
        goto out;
    }

    upload_table(table);
    if (activate) {
        sysop_sid_filter_use_custom(true);
        printf("SID filter: custom table selected\n");
    }

    rc = 0;

out:
    sysop_uninit();
    return rc;
}
