Bloodmosher/Sysop-64/linux-code/tools/bypass_keypress.c

/*
 * Sysop-64
 * https://github.com/Bloodmosher/Sysop-64
 *
 * SPDX-License-Identifier: MIT
 * Copyright (c) 2026 Sysop-64 Project
 */

#include <errno.h>
#include <signal.h>
#include <stdbool.h>
#include <stdint.h>
#include <stdio.h>
#include <stdlib.h>
#include <string.h>
#include <sys/types.h>
#include <unistd.h>
#include <limits.h>
#include <memory.h>
#include "sysop64.h"

// Pattern matching types
typedef enum {
    MATCH_DATA,      // Match on sample.data
    MATCH_ADDR,      // Match on sample.addr
    MATCH_WILDCARD,   // Match any value (wildcard)
    MATCH_WILDCARD_WRITE // Match any value (wildcard write)
} match_type_t;

typedef struct {
    match_type_t match_type;
    uint16_t value;
} pattern_step_t;

typedef struct {
    const char *description;
    pattern_step_t *steps;
    int num_steps;
    int patch_offset;      // Offset from match start to patch
    uint8_t patch_byte1;   // First byte to write
    uint8_t patch_byte2;   // Second byte to write (optional, 0 if not used)
    uint8_t patch_byte3;   // Third byte to write (optional, 0 if not used)
} pattern_t;

// Match a pattern against sampled bus activity
// Returns the starting address if found, 0 otherwise
uint16_t find_pattern(pattern_t *pattern, uint8_t *captured_wildcard)
{
    struct sysop_c64_bus_sample sample;
    int state = 0;
    uint16_t match_start_address = 0;
    int wildcard_count = 0;
    int match_start_sample_number = 0;

    // There's a trade-off here between how many samples we check and how long it takes. 1000000 samples is about 1 c64 frame, each c64 cycle gets 50 samples
    //for (int i = 0; i < SYSOP64_SAMPLER_MAX_SAMPLES; i++)
    for (int i = 0; i < 1000000; i++)
    {
        sysop_sampler_get_sample(i, &sample);

        //if (sample.sample_tick == 44 && sample.r__w == 1 && sample.phi2 == 1 && sample.ba == 1)
        if (sample.sample_tick == 44 && sample.phi2 == 1 && sample.ba == 1)
        {
            bool matched = false;
            
            if (state < pattern->num_steps)
            {
                pattern_step_t *step = &pattern->steps[state];
                
                if (step->match_type == MATCH_DATA && sample.r__w == 1)
                {
                    matched = (sample.data == step->value);
                }
                else if (step->match_type == MATCH_ADDR && sample.r__w == 1)
                {
                    matched = (sample.addr == step->value);
                }
                else if (step->match_type == MATCH_WILDCARD && sample.r__w == 1)
                {
                    matched = true;  // Always matches
                    // Capture the first wildcard value if buffer provided
                    if (captured_wildcard != NULL && wildcard_count == 0)
                    {
                        *captured_wildcard = sample.data;
                    }
                    wildcard_count++;
                }
                else if (step->match_type == MATCH_WILDCARD_WRITE && sample.r__w == 0)
                {
                    matched = true;  // Always matches
                    // Capture the first wildcard value if buffer provided
                    if (captured_wildcard != NULL && wildcard_count == 0)
                    {
                        *captured_wildcard = sample.data;
                    }
                    wildcard_count++;
                }

                if (matched)
                {
                    if (state == 0)
                    {
                        match_start_address = sample.addr;
                        match_start_sample_number = i;
                    }
                    state++;
                    
                    if (state == pattern->num_steps)
                    {
                        printf("Found pattern '%s' starting at %04X (sample %d)\n", 
                               pattern->description, match_start_address, match_start_sample_number);
                        return match_start_address;
                    }
                }
                else
                {
                    state = 0;
                    match_start_address = 0;
                    wildcard_count = 0;
                }
            }
        }
    }

    return 0;
}

int patch_space_loop()
{
    printf("Examining samples...\n");

    //11A0: AD 01 DC LDA $DC01
    //11A3: C9 EF    CMP #$EF
    //11A5: D0 F9    BNE $11A0

    // Define the pattern to match
    pattern_step_t keyboard_pattern_steps[] = {
        {MATCH_DATA, 0xAD},     // LDA opcode
        {MATCH_DATA, 0x01},     // Low byte of address
        {MATCH_DATA, 0xDC},     // High byte of address
        {MATCH_ADDR, 0xDC01},   // Address being read
        {MATCH_DATA, 0xC9},     // CMP opcode
        {MATCH_DATA, 0xEF},     // Compare value
        {MATCH_DATA, 0xD0}      // BNE opcode
    };

    pattern_t keyboard_pattern = {
        .description = "keyboard poll loop",
        .steps = keyboard_pattern_steps,
        .num_steps = sizeof(keyboard_pattern_steps) / sizeof(pattern_step_t),
        .patch_offset = 5,
        .patch_byte1 = 0xEA,    // NOP
        .patch_byte2 = 0xEA,    // NOP
        .patch_byte3 = 0x00
    };

    uint16_t match_address = find_pattern(&keyboard_pattern, NULL);

    if (match_address != 0)
    {
        //printf("Done examining samples - hit enter to patch\n");
        //getchar();

        sysop_server_dma_lock();
        // Apply the patch
        sysop_poke(match_address + keyboard_pattern.patch_offset, keyboard_pattern.patch_byte1);
        sysop_poke(match_address + keyboard_pattern.patch_offset + 1, keyboard_pattern.patch_byte2);
        sysop_server_dma_unlock();
        printf("Patch completed.\n");
        return 1;
    }
    else
    {
        printf("Pattern not found.\n");
    }
    return 0;
}

int patch_space_loop2()
{
    printf("Looking for space bar loop pattern #2\n");

    // 1949: A9 EF    LDA #$EF
    // 194B: CD 01 DC CMP $DC01
    // 194E: D0 F9    BNE $1949    

    // Define the pattern to match
    pattern_step_t keyboard_pattern_steps[] = {
        {MATCH_DATA, 0xA9},     // LDA opcode
        {MATCH_DATA, 0xEF},     // Immediate value
        {MATCH_DATA, 0xCD},     // CMP opcode
        {MATCH_DATA, 0x01},     // Low byte of address
        {MATCH_DATA, 0xDC},     // High byte of address
        {MATCH_ADDR, 0xDC01},   // Address being read
        {MATCH_DATA, 0xD0}      // BNE opcode
    };

    pattern_t keyboard_pattern = {
        .description = "keyboard poll loop 2",
        .steps = keyboard_pattern_steps,
        .num_steps = sizeof(keyboard_pattern_steps) / sizeof(pattern_step_t),
        .patch_offset = 5,
        .patch_byte1 = 0xEA,    // NOP
        .patch_byte2 = 0xEA,    // NOP
        .patch_byte3 = 0x00
    };

    uint16_t match_address = find_pattern(&keyboard_pattern, NULL);

    if (match_address != 0)
    {
        //printf("Done examining samples - hit enter to patch\n");
        //getchar();

        printf("Found space bar loop pattern #2 at %04X\n", match_address);

        sysop_server_dma_lock();
        // Apply the patch
        sysop_poke(match_address + keyboard_pattern.patch_offset, keyboard_pattern.patch_byte1);
        sysop_poke(match_address + keyboard_pattern.patch_offset + 1, keyboard_pattern.patch_byte2);
        sysop_server_dma_unlock();
        printf("Patch completed.\n");
        return 1;
    }
    else
    {
        printf("Pattern not found.\n");
    }
    return 0;
}
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
